hsetlik/Ultra64_mk2/Schematic/Ultra64_mk2.kicad_pcb

## KiCad design Schematic/Ultra64_mk2.kicad_pcb (2024-05-18)

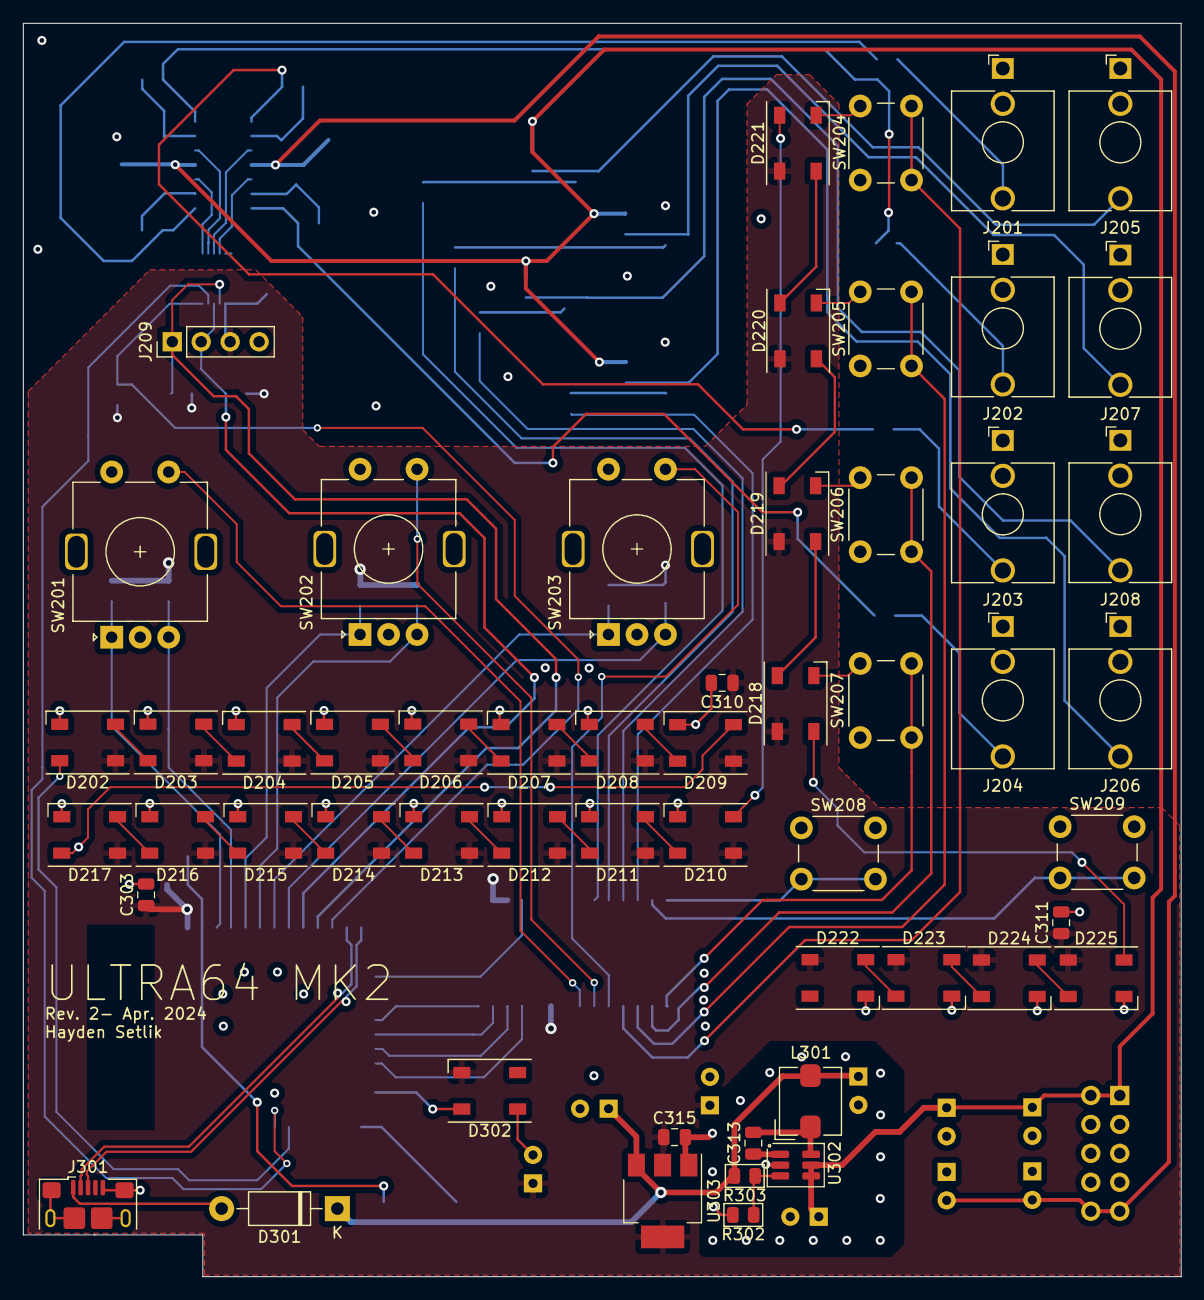
[picture p1: board Ultra64_mk2.kicad_pcb from above]

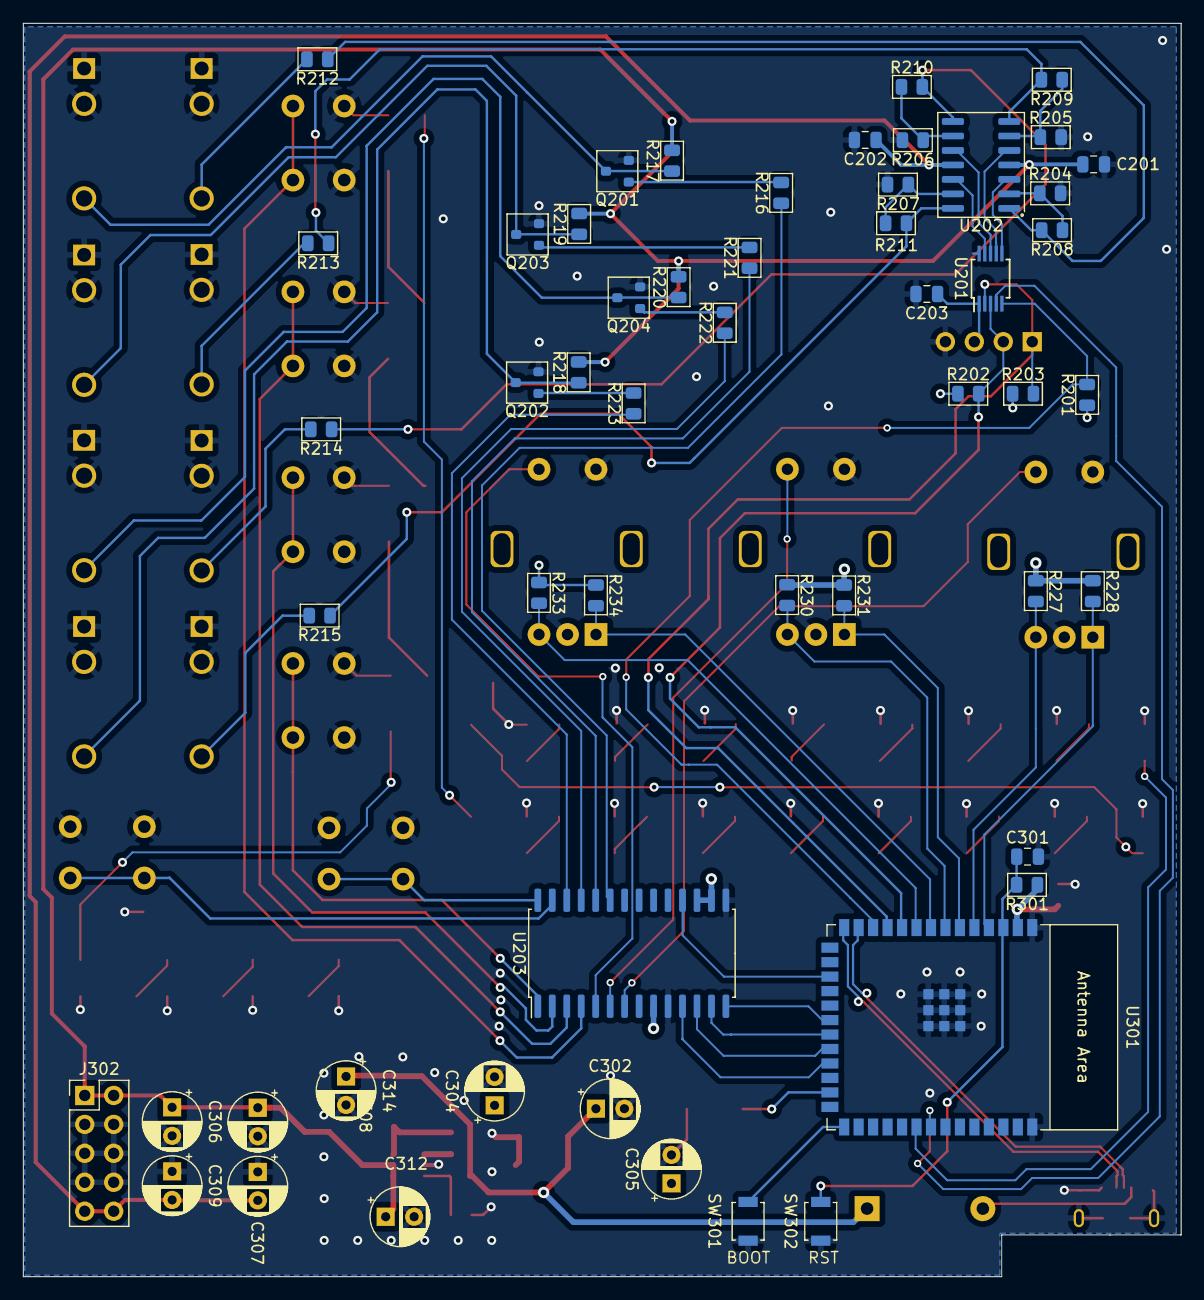
[picture p2: board Ultra64_mk2.kicad_pcb from below]

Board: 4 copper layers, 101.6 x 110.0 mm, 109 parts (54 on the bottom side), 90 nets.

Parts:
C201, C202, C203, C301, C303, C313: 0.1uF; C_0805_2012Metric
C302, C304, C305, C312, C314: 10uF; CP_Radial_D5.0mm_P2.50mm
C306, C307, C309: 22uF; CP_Radial_D5.0mm_P2.50mm
C308: 2.2uF; CP_Radial_D5.0mm_P2.50mm
C310: 2.2nF; C_0805_2012Metric
C311: 220nF; C_0805_2012Metric
C315: 2.2uF; C_0805_2012Metric
D202, D203, D204, D205, D206, D207, D208, D209, D210, D211, D212, D213, D214, D215, D216, D217, D218, D219, D220, D221, D222, D223, D224, D225: SK6812; LED_SK6812_PLCC4_5.0x5.0mm_P3.2mm
D301: 1N4002; D_DO-41_SOD81_P10.16mm_Horizontal
D302: WS2812B; LED_SK6812_PLCC4_5.0x5.0mm_P3.2mm
J201: CV1; Jack_3.5mm_QingPu_WQP-PJ398SM_Vertical_CircularHoles
J202: CV2; Jack_3.5mm_QingPu_WQP-PJ398SM_Vertical_CircularHoles
J203: CV3; Jack_3.5mm_QingPu_WQP-PJ398SM_Vertical_CircularHoles
J204: CV4; Jack_3.5mm_QingPu_WQP-PJ398SM_Vertical_CircularHoles
J205: GATE1; Jack_3.5mm_QingPu_WQP-PJ398SM_Vertical_CircularHoles
J206: GATE4; Jack_3.5mm_QingPu_WQP-PJ398SM_Vertical_CircularHoles
J207: GATE2; Jack_3.5mm_QingPu_WQP-PJ398SM_Vertical_CircularHoles
J208: GATE3; Jack_3.5mm_QingPu_WQP-PJ398SM_Vertical_CircularHoles
J209: Display; PinHeader_1x04_P2.54mm_Vertical
J301: USB_B_Micro; USB_Micro-B_Amphenol_10118193-0001LF_Horizontal
J302: Conn_02x05_Odd_Even; PinHeader_2x05_P2.54mm_Vertical
L301: 4.7uH; L_Bourns_SRP5030T
Q201, Q202, Q203, Q204: BC847; SOT-23
R201: 100k; R_0805_2012Metric
R202, R203: 2k2; R_0805_2012Metric
R204, R205, R206, R207: 47k; R_0805_2012Metric
R208, R209, R210, R211: 68k; R_0805_2012Metric
R212, R213, R214, R215: 220R; R_0805_2012Metric
R216, R221, R222, R223: 1k; R_0805_2012Metric
R217, R218, R219, R220, R227, R228, R230, R231, R233, R234, R301: 10k; R_0805_2012Metric
R302: 22k; R_0805_2012Metric
R303: 89k; R_0805_2012Metric
SW201, SW202, SW203: RotaryEncoder_Switch; RotaryEncoder_Alps_EC11E-Switch_Vertical_H20mm_5Pin
SW204, SW205, SW206, SW207, SW208, SW209: SW_SPST; SW_PUSH_6mm_H5mm
SW301, SW302: SW_SPST; SW_SPST_B3U-1000P
U201: MCP4728; MSOP-10_3x3mm_P0.5mm
U202: TL074; SOIC-14_3.9x8.7mm_P1.27mm
U203: MCP23S17_SO; SOIC-28W_7.5x17.9mm_P1.27mm
U301: ESP32-S3-WROOM-1
U302: LMR50410-Q; SOT-23-6_BigPads
U303: AMS1117; SOT-223-3_TabPin2

Connections:
+3.3V: C203.1, C303.1, C304.1, C305.1, C310.1, C311.1, C315.1, D202.3 (VDD), D203.3 (VDD), D204.3 (VDD), D205.3 (VDD), D206.3 (VDD), D207.3 (VDD), D208.3 (VDD), D209.3 (VDD), D210.3 (VDD), D211.3 (VDD), D212.3 (VDD), D213.3 (VDD), D214.3 (VDD), D215.3 (VDD), D216.3 (VDD), D217.3 (VDD), D218.3 (VDD), D219.3 (VDD), D220.3 (VDD), D221.3 (VDD), D222.3 (VDD), D223.3 (VDD), D224.3 (VDD), D225.3 (VDD), D302.1 (VDD), J209.3, R201.1, R202.1, R203.1, R227.1, R228.1, R230.1, R231.1, R233.1, R234.1, R301.1, U201.1 (VDD), U203.9 (VDD), U203.16 (A1), U203.17 (A2), U301.2 (3V3), U303.2 (VO)
+5V: C302.1, C314.1, D301.1 (K), L301.2, R303.2, U303.3 (VI)
+12V: C201.1, C306.1, C308.1, C312.1, J302.1, J302.2, R217.2, R218.2, R219.2, R220.2, U202.4 (V+), U302.4 (EN), U302.5 (VIN)
-12V: C202.1, C307.2, C309.2, J302.9, J302.10, U202.11 (V-)
C1: SW204.2 (B), U203.4 (GPB3)
C1_CV: J201.T, R212.2
C1_GATE: J205.T, Q201.3 (C), R217.1
C2: SW205.2 (B), U203.3 (GPB2)
C2_CV: J202.T, R213.2
C2_GATE: J207.T, Q203.3 (C), R219.1
C3: SW206.2 (B), U203.2 (GPB1)
C3_CV: J203.T, R214.2
C3_GATE: J208.T, Q204.3 (C), R220.1
C4: SW207.2 (B), U203.1 (GPB0)
C4_CV: J204.T, R215.2
C4_GATE: J206.T, Q202.3 (C), R218.1
DAC_RDY: R201.2, U201.5 (RDY/~BSY), U301.12 (GPIO8/TOUCH8/ADC1_CH7/SUBSPICS1)
EN: C301.1, R301.2, SW302.1 (A), U301.3 (EN)
ENCA_B: SW201.S1, U203.7 (GPB6)
ENCA_L: R228.2, SW201.A, U301.4 (GPIO4/TOUCH4/ADC1_CH3)
ENCA_R: R227.2, SW201.B, U301.5 (GPIO5/TOUCH5/ADC1_CH4)
ENCB_B: SW202.S1, U203.6 (GPB5)
ENCB_L: R231.2, SW202.A, U301.6 (GPIO6/TOUCH6/ADC1_CH5)
ENCB_R: R230.2, SW202.B, U301.7 (GPIO7/TOUCH7/ADC1_CH6)
ENCC_B: SW203.S1, U203.5 (GPB4)
ENCC_L: R234.2, SW203.A, U301.8 (GPIO15/U0RTS/ADC2_CH4/XTAL_32K_P)
ENCC_R: R233.2, SW203.B, U301.9 (GPIO16/U0CTS/ADC2_CH5/XTAL_32K_N)
EXP_CS: U203.11 (~CS), U301.23 (GPIO21)
EXP_RST: U203.18 (~RESET), U301.17 (GPIO9/TOUCH9/ADC1_CH8/FSPIHD/SUBSPIHD)
GND: C201.2, C202.2, C203.2, C301.2, C302.2, C303.2, C304.2, C305.2, C306.2, C307.1, C308.2, C309.1, C310.2, C311.2, C312.2, C314.2, C315.2, D202.1 (VSS), D203.1 (VSS), D204.1 (VSS), D205.1 (VSS), D206.1 (VSS), D207.1 (VSS), D208.1 (VSS), D209.1 (VSS), D210.1 (VSS), D211.1 (VSS), D212.1 (VSS), D213.1 (VSS), D214.1 (VSS), D215.1 (VSS), D216.1 (VSS), D217.1 (VSS), D218.1 (VSS), D219.1 (VSS), D220.1 (VSS), D221.1 (VSS), D222.1 (VSS), D223.1 (VSS), D224.1 (VSS), D225.1 (VSS), D302.3 (VSS), J201.S, J201.TN, J202.S, J202.TN, J203.S, J203.TN, J204.S, J204.TN, J205.S, J205.TN, J206.S, J206.TN, J207.S, J207.TN, J208.S, J208.TN, J209.4, J301.5 (GND), J301.6 (Shield), J302.3, J302.4, J302.5, J302.6, J302.7, J302.8, Q201.2 (E), Q202.2 (E), Q203.2 (E), Q204.2 (E), R204.2, R205.2, R206.2, R207.2, R302.2, SW201.C, SW201.S2, SW202.C, SW202.S2, SW203.C, SW203.S2, SW204.1 (A), SW205.1 (A), SW206.1 (A), SW207.1 (A), SW208.1 (A), SW209.1 (A), SW301.2 (B), SW302.2 (B), U201.10 (VSS), U203.10 (VSS), U203.15 (A0), U301.1 (GND), U301.40 (GND), U301.41 (GND), U302.2 (GND), U303.1 (ADJ)
LDAC: U201.4 (~LDAC), U301.33 (MTDO/GPIO40/CLK_OUT2)
MISO: U203.14 (SO), U301.20 (GPIO12/TOUCH12/ADC2_CH1/FSPICLK/FSPIIO6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)
MOSI: U203.13 (SI), U301.21 (GPIO13/TOUCH13/ADC2_CH2/FSPIQ/FSPIIO7/S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)
unnamed: D202.4 (DOUT), D203.2 (DIN)
unnamed: D203.4 (DOUT), D204.2 (DIN)
unnamed: D204.4 (DOUT), D205.2 (DIN)
unnamed: D205.4 (DOUT), D206.2 (DIN)
unnamed: D206.4 (DOUT), D207.2 (DIN)
unnamed: D207.4 (DOUT), D208.2 (DIN)
unnamed: D208.4 (DOUT), D209.2 (DIN)
unnamed: D209.4 (DOUT), D217.2 (DIN)
unnamed: D210.2 (DIN), D211.4 (DOUT)
unnamed: D210.4 (DOUT), D221.2 (DIN)
unnamed: D211.2 (DIN), D212.4 (DOUT)
unnamed: D212.2 (DIN), D213.4 (DOUT)
unnamed: D213.2 (DIN), D214.4 (DOUT)
unnamed: D214.2 (DIN), D215.4 (DOUT)
unnamed: D215.2 (DIN), D216.4 (DOUT)
unnamed: D216.2 (DIN), D217.4 (DOUT)
unnamed: D218.2 (DIN), D219.4 (DOUT)
unnamed: D218.4 (DOUT), D225.2 (DIN)
unnamed: D219.2 (DIN), D220.4 (DOUT)
unnamed: D220.2 (DIN), D221.4 (DOUT)
unnamed: D222.2 (DIN), D223.4 (DOUT)
unnamed: D223.2 (DIN), D224.4 (DOUT)
unnamed: D224.2 (DIN), D225.4 (DOUT)
unnamed: D302.2 (DOUT), U301.25 (GPIO48/SPICLK_N/SUBSPICLK_N_DIFF)
unnamed: Q201.1 (B), R216.2
unnamed: Q202.1 (B), R223.2
unnamed: Q203.1 (B), R221.2
unnamed: Q204.1 (B), R222.2
unnamed: R208.2, R212.1, U202.1
unnamed: R209.2, R213.1, U202.7
unnamed: R210.2, R214.1, U202.8
unnamed: R211.2, R215.1, U202.14
unnamed: SW301.1 (A), U301.27 (GPIO0/BOOT)
unnamed: U201.6 (VOUTA), U202.3 (+)
unnamed: U201.7 (VOUTB), U202.5 (+)
unnamed: U201.8 (VOUTC), U202.10 (+)
unnamed: U201.9 (VOUTD), U202.12 (+)
unnamed: R204.1, R208.1, U202.2 (-)
unnamed: R205.1, R209.1, U202.6 (-)
unnamed: R206.1, R210.1, U202.9 (-)
unnamed: R207.1, R211.1, U202.13 (-)
unnamed: R216.1, U203.23 (GPA2)
unnamed: R221.1, U203.24 (GPA3)
unnamed: R222.1, U203.25 (GPA4)
unnamed: R223.1, U203.26 (GPA5)
unnamed: C313.1, U302.1 (CB)
unnamed: R302.1, R303.1, U302.3 (FB)
unnamed: C313.2, L301.1, U302.6 (SW)
PG_LEFT: SW208.2 (B), U203.28 (GPA7)
PG_RIGHT: SW209.2 (B), U203.27 (GPA6)
PIXELS: D202.2 (DIN), U301.32 (MTCK/GPIO39/CLK_OUT3/SUBSPICS1)
SCK: U203.12 (SCK), U301.22 (GPIO14/TOUCH14/ADC2_CH3/FSPIWP/FSPIDQS/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)
SCL: J209.2, R202.2, U201.3 (SDA), U301.10 (GPIO17/U1TXD/ADC2_CH6)
SDA: J209.1, R203.2, U201.2 (SCL), U301.11 (GPIO18/U1RXD/ADC2_CH7/CLK_OUT3)
USB+: J301.3 (D+), U301.14 (GPIO20/U1CTS/ADC2_CH9/CLK_OUT1/USB_D+)
USB-: J301.2 (D-), U301.13 (GPIO19/U1RTS/ADC2_CH8/CLK_OUT2/USB_D-)
V_USB: D301.2 (A), J301.1 (VBUS)
