hsetlik/Ultra64_mk2/src/main.cpp

#include "Sequencer.h"
#include "esp_system.h"
#include "rom/ets_sys.h"
//
Ultra64 seq;

RotaryEncoder encA(ENCA_L, ENCA_R, RotaryEncoder::LatchMode::TWO03);
RotaryEncoder encB(ENCB_L, ENCB_R, RotaryEncoder::LatchMode::TWO03);
RotaryEncoder encC(ENCC_L, ENCC_R, RotaryEncoder::LatchMode::TWO03);

Adafruit_MCP23X17 expander;
Adafruit_MCP4728 dac;

// Volatile vars for the input ISR
volatile long encAPos = 0;
volatile long encBPos = 0;
volatile long encCPos = 0;
volatile uint16_t inputState;
volatile bool newInputsReady = false;

// vars for the output ISR 

volatile uint64_t prevOutputs;
volatile uint64_t currentOutputs;
volatile bool needsNewOutputs = false;

//hardware timers for our two ISRs
hw_timer_t* inTimer = NULL;
hw_timer_t* outTimer = NULL;

// critical section
portMUX_TYPE timerMux1 = portMUX_INITIALIZER_UNLOCKED;
portMUX_TYPE timerMux2 = portMUX_INITIALIZER_UNLOCKED;

//our ISR functions
void ARDUINO_ISR_ATTR inputISR()
{
  portENTER_CRITICAL_ISR(&timerMux1);

  uint16_t is = 0;
  // encoders
  encA.tick();
  auto aPos = encA.getPosition();
  if(aPos != encAPos)
  {
    Input::addEncoderState(is, 0, aPos < encAPos);
    encAPos = aPos;
  }

  encB.tick();
  auto bPos = encB.getPosition();
  if(bPos != encBPos)
  {
    Input::addEncoderState(is, 1, bPos < encBPos);
    encBPos = bPos;
  }

  encC.tick();
  auto cPos = encC.getPosition();
  if(cPos != encCPos)
  {
    Input::addEncoderState(is, 2, cPos < encCPos);
    encCPos = cPos;
  }


  // buttons
  uint8_t bitsA = expander.readGPIOA();
  uint8_t bitsB = expander.readGPIOB();
  
  Input::setButtonState(is, EncA, bitsB & (1 << ENCA_BIT));
  Input::setButtonState(is, EncB, bitsB & (1 << ENCB_BIT));
  Input::setButtonState(is, EncC, bitsB & (1 << ENCC_BIT));

  Input::setButtonState(is, C1, bitsA & (1 << CH1_BIT));
  Input::setButtonState(is, C2, bitsA & (1 << CH2_BIT));
  Input::setButtonState(is, C3, bitsA & (1 << CH3_BIT));
  Input::setButtonState(is, C4, bitsA & (1 << CH4_BIT));
  Input::setButtonState(is, PL, bitsA & (1 << P_LEFT_BIT));
  Input::setButtonState(is, PR, bitsA & (1 << P_RIGHT_BIT));

  inputState = is;
  newInputsReady = true;
  portEXIT_CRITICAL_ISR(&timerMux1);
}

void ARDUINO_ISR_ATTR outputISR()
{
  portENTER_CRITICAL_ISR(&timerMux2);
  
  // packing all the output data into one 64 bit
  // variable lets us check if we need to update
  // anything with just one equality check
  if(currentOutputs != prevOutputs)
  {
    for(uint8_t ch = 0; ch < 4; ch++)
    {
      uint16_t currentVal = Output::getDacValue(currentOutputs, ch);
      if(Output::getDacValue(prevOutputs, ch) != currentVal)
      {
        dac.setChannelValue((MCP4728_channel_t)ch, currentVal, MCP4728_VREF_INTERNAL, MCP4728_GAIN_2X);
      }
      bool currentGate = Output::getGateValue(currentOutputs, ch);
      if(Output::getGateValue(prevOutputs, ch) != currentGate)
      {
        switch(ch)
        {
          case 0:
            expander.digitalWrite(GATE1, !currentGate);
            break;
          case 1:
            expander.digitalWrite(GATE2, !currentGate);
            break;
          case 2:
            expander.digitalWrite(GATE3, !currentGate);
            break;
          case 3:
            expander.digitalWrite(GATE4, !currentGate);
            break;
          default:
            break;
        }
      }
    }
    prevOutputs = currentOutputs;
    needsNewOutputs = true;
  }
  portEXIT_CRITICAL_ISR(&timerMux2);
}
//===============================================================

void setup()
{
  // start serial communication
  Serial.begin(115200);
  pinMode(EXP_RST, OUTPUT);
  digitalWrite(EXP_RST, HIGH);
  // initialize sequencer
  seq.init();
  seq.pushMessage("Seq. Initialized!");
  // set pin modes
  pinMode(EXP_CS, OUTPUT);
  digitalWrite(EXP_CS, HIGH);
  // set up SPI and initialize the MCP23S17 expander
  SPI.begin(SCK, MISO, MOSI, EXP_CS);
  if (!expander.begin_SPI(EXP_CS, &SPI, HW_ADDR))
  {
    Serial.println("Error! Failed to initialize IO expander!");
  }
  expander.pinMode(ENCA_B, INPUT);
  expander.pinMode(ENCB_B, INPUT);
  expander.pinMode(ENCC_B, INPUT);

  expander.pinMode(CH1, INPUT);
  expander.pinMode(CH2, INPUT);
  expander.pinMode(CH3, INPUT);
  expander.pinMode(CH4, INPUT);

  expander.pinMode(P_LEFT, INPUT);
  expander.pinMode(P_RIGHT, INPUT);

  expander.pinMode(GATE1, OUTPUT);
  expander.pinMode(GATE2, OUTPUT);
  expander.pinMode(GATE3, OUTPUT);
  expander.pinMode(GATE4, OUTPUT);

  expander.digitalWrite(GATE1, HIGH);
  expander.digitalWrite(GATE2, HIGH);
  expander.digitalWrite(GATE3, HIGH);
  expander.digitalWrite(GATE4, HIGH);

  //set up DAC
  if(!dac.begin())
  {
    Serial.println("Failed to initialize DAC!");
  }
  else
  {
    Serial.println("DAC Initialized!");
  }

  //set up hardware timers and interrupts
  inTimer = timerBegin(0, 80, true);
  timerAttachInterrupt(inTimer, &inputISR, true);
  timerAlarmWrite(inTimer, 1000000 / INPUT_POLLING_HZ, true);
  timerAlarmEnable(inTimer);
  Serial.println("Attached input interrupt");
  //seq.pushMessage("Attached input interrupt");

  // now the output timer
  outTimer = timerBegin(1, 80, true);
  timerAttachInterrupt(outTimer, &outputISR, true);
  timerAlarmWrite(outTimer, 1000000 / OUTPUT_UPDATE_HZ, true);
  timerAlarmEnable(outTimer);
  Serial.println("Attached output interrupt");
  //seq.pushMessage("Attached output interrupt");
}

void loop()
{
  // put your main code here, to run repeatedly:
  seq.tickReadouts();
  if(newInputsReady)
  {
    portENTER_CRITICAL_ISR(&timerMux1);
    seq.updateInputs(inputState);
    newInputsReady = false;
    portEXIT_CRITICAL_ISR(&timerMux1);
  }

  if(needsNewOutputs)
  {
    portENTER_CRITICAL_ISR(&timerMux2);
    currentOutputs = seq.getOutputState();
    needsNewOutputs = false;
    portEXIT_CRITICAL_ISR(&timerMux2);
  }
}
