hsetlik/Ultra64_mk2/include/Sequencer.h

#pragma once
#include "Pins.h"
#include <Adafruit_MCP23X17.h>
#include <Adafruit_MCP4728.h>
#include <Adafruit_SSD1306.h>
#include <RotaryEncoder.h>
#include <FastLED.h>
#include <array>
#include <Wire.h>
#include "Button.h"
#include "Sequence.h"
#include "InputState.h"

#define PIXEL_INTERVAL 50
#define DISPLAY_INTERVAL 41

// defaults and ranges
#define TEMPO_DEFAULT 120
#define TEMPO_MIN 25
#define TEMPO_MAX 360

#define OUTPUT_UPDATE_HZ 1000
#define INPUT_POLLING_HZ 850

#define HALFSTEP_INCREMENT 26.167f

#define SCREEN_WIDTH 128
#define SCREEN_HEIGHT 32
#define SCREEN_ADDRESS 0x3C

struct MessageBuffer
{
private:
    String messages[16];
    uint8_t head;
public:
    MessageBuffer() : head(0) {}
    void push(const String& msg)
    {
        messages[head] = msg;
        head = (head + 1) % 16;
    }
    String& operator[](uint8_t idx)
    {
        uint8_t i = (head + idx) % 16;
        return messages[i];
    }

};




class Ultra64
{
public:
    Ultra64();
    ~Ultra64();
    // call this in setup() to allocate everything and do setup stuff
    void init();
    // check the encoders and buttons, call this on a timer interrupt
    void updateInputs(uint16_t data);
    //get the output state to update as needed in the ISR
    OutputState getOutputs();
    uint64_t getOutputState();
    // call this in loop() in main.cpp. Handles updates to the pixels and display
    void tickReadouts();
    void pushMessage(const String& msg)
    {
        log.push(msg);
    }

private:
    // ---------- Hardware -------------
   // Adafruit_NeoPixel *pixels;
   CRGB pixels[24];

    Adafruit_SSD1306* display;
    MessageBuffer log;

    //new button stuff
    Button buttons[9];


    // this is used to safely store the data from the volatile variable that the ISR updates
    uint16_t inputState = 0;
    //keep track of when we update the pixels and display
    unsigned long lastDisplayUpdate;
    unsigned long lastPixelUpdate;
    // helper function for the gate outputs
    //--------------------------------------
    // ---------- State Variables ----------
    uint16_t currentTempo = TEMPO_DEFAULT;
    uint8_t currentStep = 0;
    uint8_t selectedTrack = 0;
    uint8_t selectedStep = 0;
    bool isPlaying = false;
    bool quarterMode = false;
    bool lengthMode = false;
    Sequence seq;
    //--------------------------------------
    Step &getSelected() { return seq.tracks[selectedTrack][selectedStep]; }
    // control callback stuff-----------------------
    void encoderTurned(uint8_t enc, bool up);
    void buttonPressed(ButtonID id);
    void buttonHeld(ButtonID id);

    void shiftTempo(bool dir);
    void shiftSelectedStep(bool dir);
    void shiftStepNote(bool dir);
    void shiftStepLength(bool dir);
    //--------------------------------------
    //--------helpers for the readouts------
    CRGB noteOnColors[12];
    CRGB noteSelectedColors[12];

    const CHSV minLengthColor;
    const CHSV maxLengthColor;
    const CRGB offColor;
    const CRGB onColor;


    void updateDisplay();
    void updatePixels();
    //--------------------------------------
    // helpers for timing math
    const float sampleIntervalMs = 1000.0f / (float)OUTPUT_UPDATE_HZ;
    float stepLengthMs = 60000.0f / (float)TEMPO_DEFAULT;
    float msIntoSequence = 0.0f;
    float msIntoStep = 0.0f;
    float noteLengthMs(uint8_t length);
};
