hsetlik/Ultra64_mk2/(commit log)

2024-03-29 wiring up control stuff
2024-03-29 SPI and button handling
2024-03-30 switched to FastLED, color math
2024-04-07 Output ISR
    [IO.kicad_sch]
2024-04-10 Rev. 2 schematic and PCB
    [IO.kicad_sch, MCU.kicad_sch]
2024-04-10 PCB in git
    [IO.kicad_sch, Ultra64_mk2.kicad_pcb]
2024-05-18 fixed pins
    [Ultra64_mk2.kicad_pcb]
2024-05-18 new button class
